cillian64/smalltime/README.md

# smalltime
Little LED desk clock with TCXO RTC

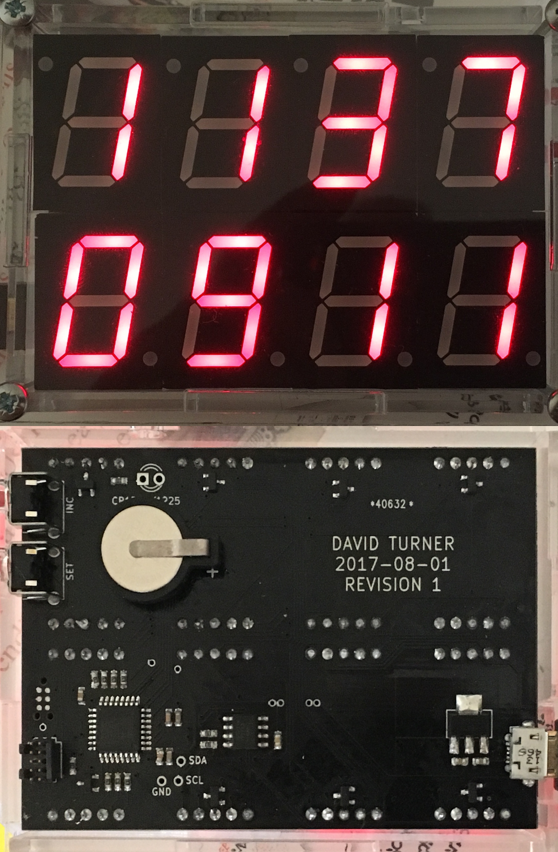
[picture p1: smalltime.png]
Photos of the front and back of the clock
