cillian64/smalltime/pins.txt

I2C locations:
I2C1 pin PB6-7

Analog inputs:
PA0-7
PB0-1

Total GPIOS required: 23
Total GPIOs avail: 23
