cillian64/smalltime/case/case.dxf

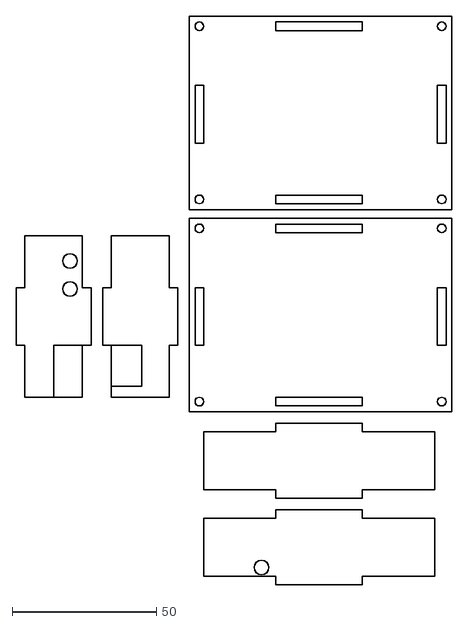
[picture p2: CAD file, 2017-08-18]
case/case.dxf
151.0 x 197.0
