cillian64/smalltime/(list of files, cad)

Other CAD files:
board/gerbers/smalltime-F.Paste.dxf
