cillian64/smalltime/board/smalltime.pdf

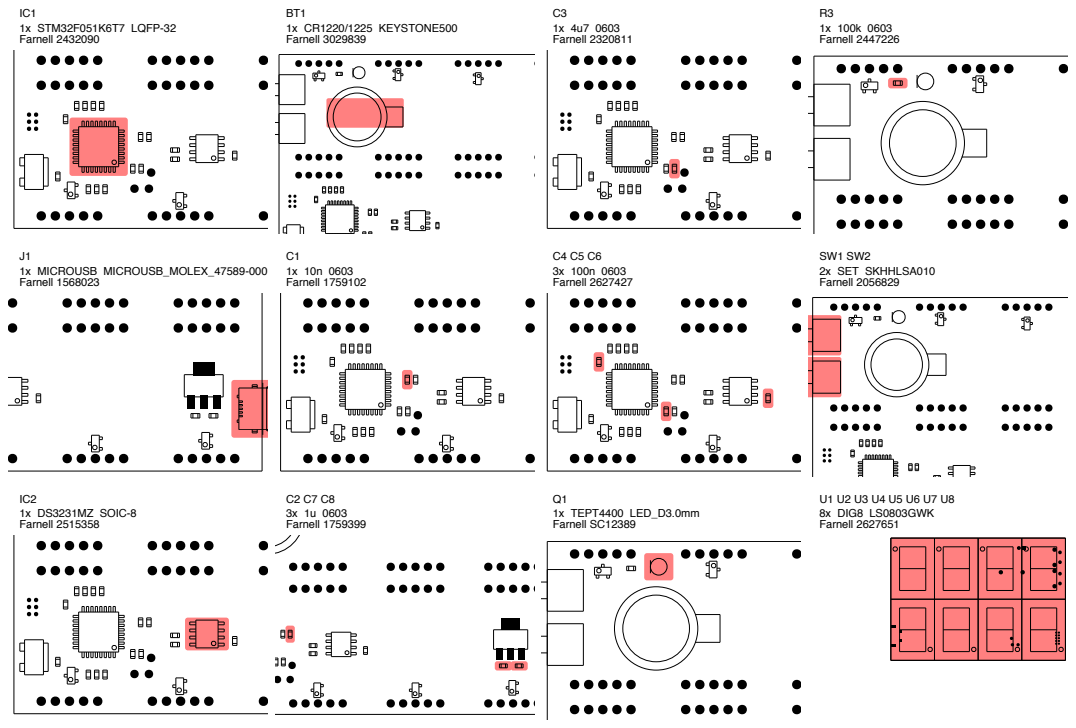
[picture p3: page 1]

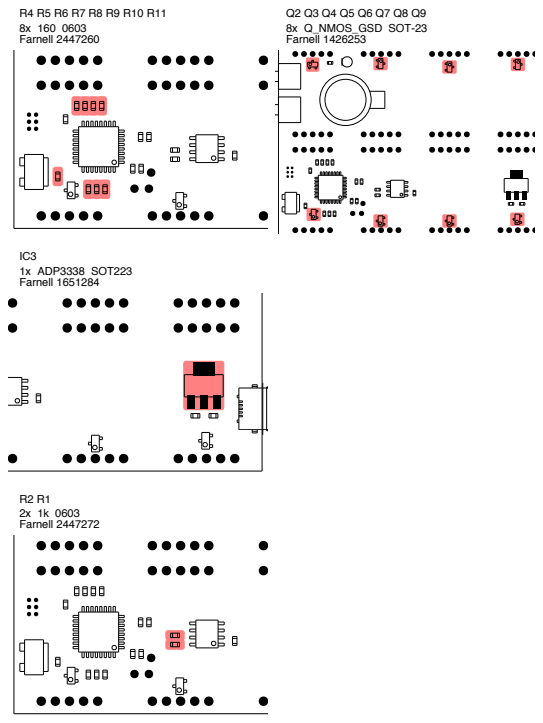
[picture p4: page 2]
