cillian64/smalltime/(commit log)

2017-07-19 added agg-kicad
2017-07-19 board initial commit
    [smalltime.kicad_pcb, smalltime.sch]
2017-07-21 bump agg-kicad for ds3231
2017-07-22 Added all parts to schematic
    [smalltime.sch]
2017-07-24 Added values and order codes
    [smalltime.sch]
2017-07-24 Added part number for push switches
    [smalltime.sch]
2017-07-24 Added footprints for 7seg display and switches
    [smalltime.sch]
2017-07-26 initial board outline
    [smalltime.kicad_pcb, smalltime.sch]
2017-07-26 bigger 7segs, better LDO, NFETs, CR1220
    [smalltime.kicad_pcb, smalltime.sch]
2017-07-26 removed unnecessary pullups
    [smalltime.kicad_pcb, smalltime.sch]
2017-07-27 Flipped and routed 7segs
    [smalltime.kicad_pcb]
2017-07-27 Did some more routing.
    [smalltime.kicad_pcb, smalltime.sch]
2017-07-31 Nominally finished routing
    [smalltime.kicad_pcb, smalltime.sch]
2017-07-31 minor routing improvements
    [smalltime.kicad_pcb, smalltime.sch]
2017-08-01 Schematic checking/finishing
    [smalltime.kicad_pcb, smalltime.sch]
2017-08-01 Finishing touches and checking, silk
    [smalltime-B.Cu.gbl, smalltime-B.Mask.gbs, smalltime-B.SilkS.gbo, smalltime-Edge.Cuts.gbr, smalltime-F.Cu.gtl, smalltime-F.Mask.gts, smalltime-F.SilkS.gto, smalltime.drl]
2017-08-02 Add 1kR order#, add BOM
    [smalltime.sch]
2017-08-04 Replace STM32F030K6 with STM32F051K6 for more RAM
    [smalltime.sch]
2017-08-04 Change ST support to 32bit timer on TIM2
2017-08-11 laser cut case
    [case.dxf]
2017-08-18 case r2
    [case.dxf]
2017-08-18 put swdio/swclk in board.h
2017-08-19 ds3231 driver
2017-08-19 paste dxf and stickerbom pdf
    [smalltime-F.Paste.dxf]
2019-03-02 Change ADP3338 to 3v3 part
    BOM accidentally had 5V output ADP3338: change farnell part to 3v3 one.
    [smalltime.sch]
